DrumClock/AutoRotace/IMG_arduino.jpg

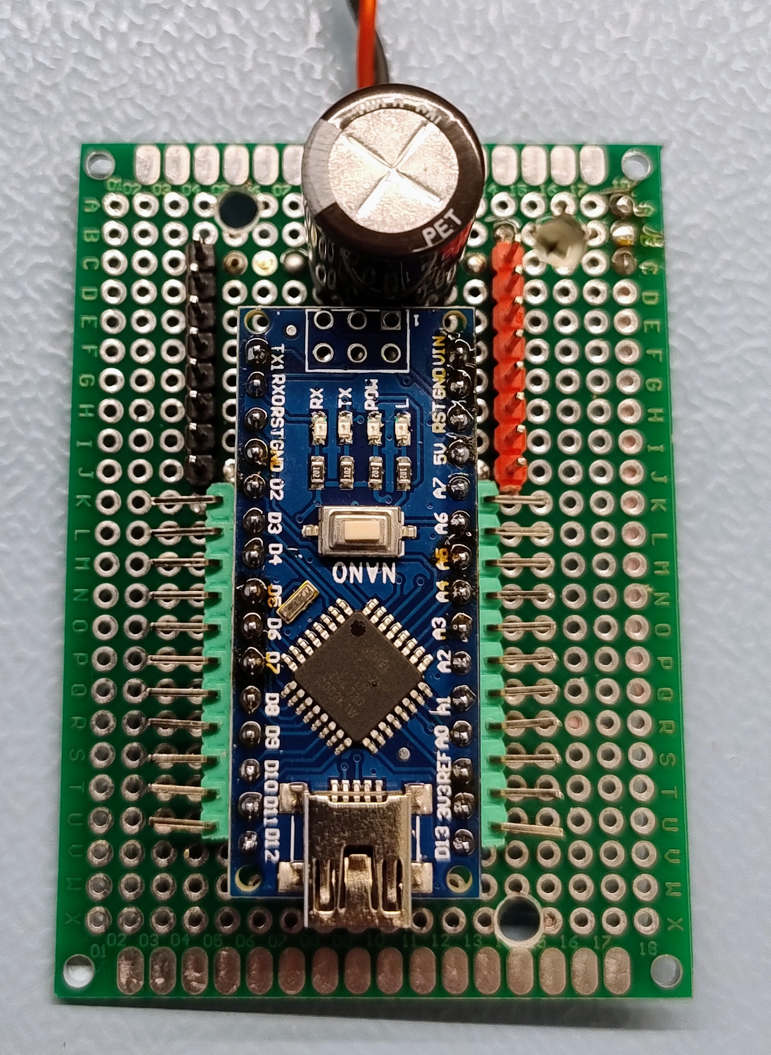
IMG_arduino.jpg
