DrumClock/AutoRotace/FreeCAD/SEVER_BEDNA_VRSEK_320mm.FCStd

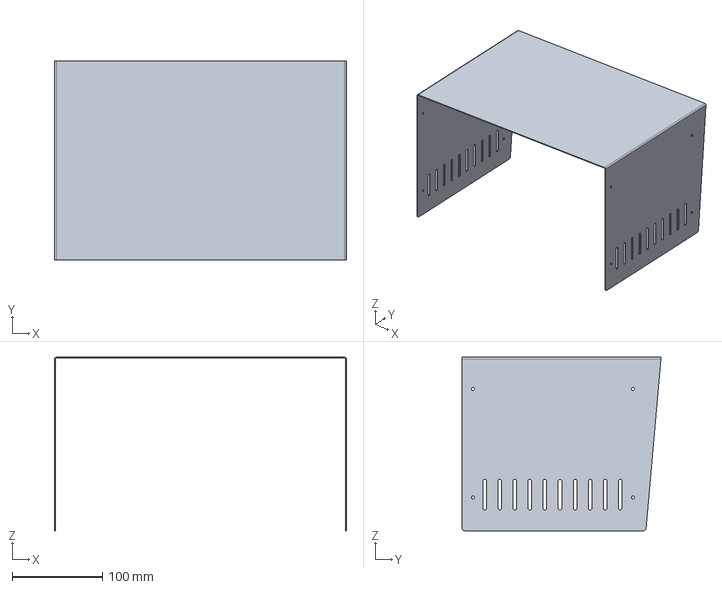
[picture p9: CAD file, 2025-06-11]
FreeCAD/SEVER_BEDNA_VRSEK_320mm.FCStd
323.0 x 220.0 x 192.0 mm
