DrumClock/AutoRotace/FreeCAD/bedna_nozicka.FCStd

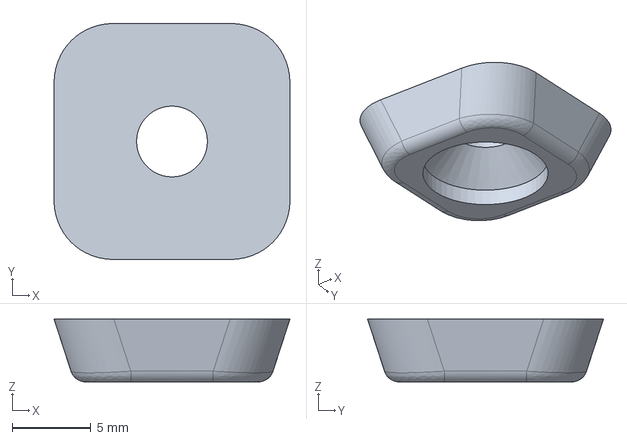
[picture p10: CAD file, 2025-06-11]
FreeCAD/bedna_nozicka.FCStd
15.0 x 15.0 x 4.00 mm
