DrumClock/AutoRotace/FreeCAD/SEVER_BEDNA_ZP_320mm.FCStd

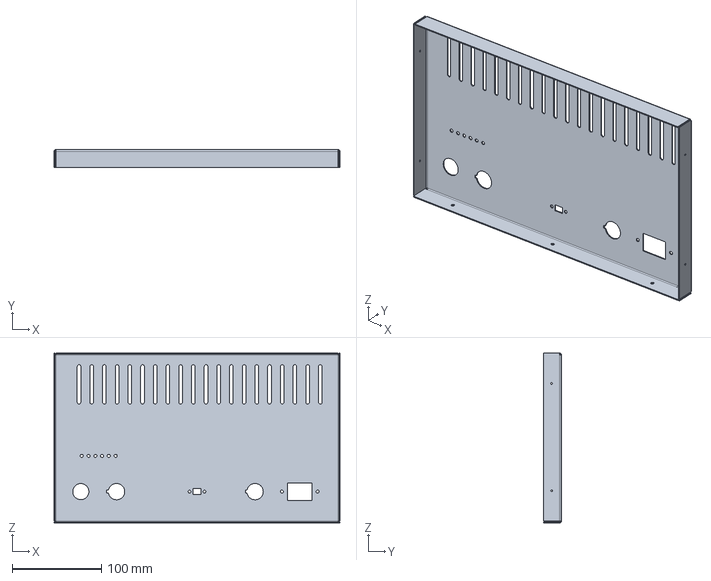
[picture p11: CAD file, 2025-06-11]
FreeCAD/SEVER_BEDNA_ZP_320mm.FCStd
320.0 x 20.0 x 190.0 mm
