DrumClock/AutoRotace/FreeCAD/SEVER_LOC.FCStd

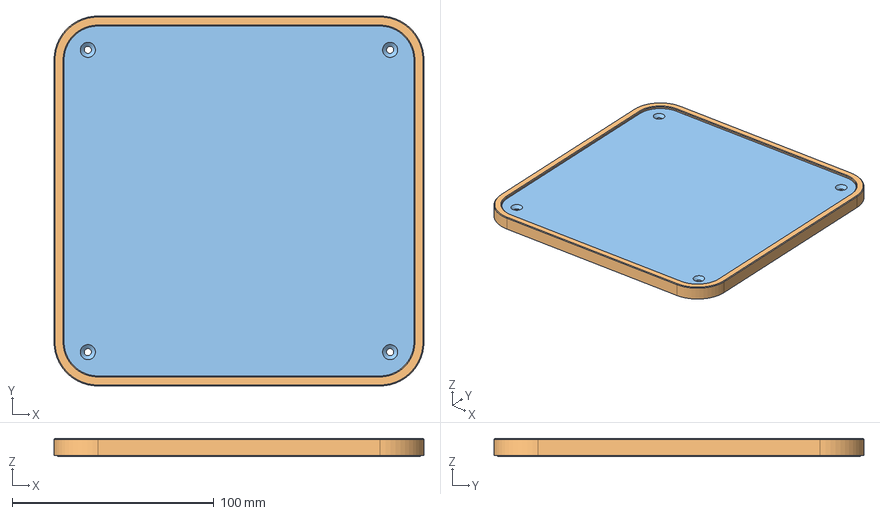
[picture p12: CAD file, 2025-06-11]
FreeCAD/SEVER_LOC.FCStd
183.6 x 183.6 x 9.10 mm
LED držák
rámeček
plexi 3mm
