DrumClock/AutoRotace/FreeCAD/rotace_tlacitka.FCStd

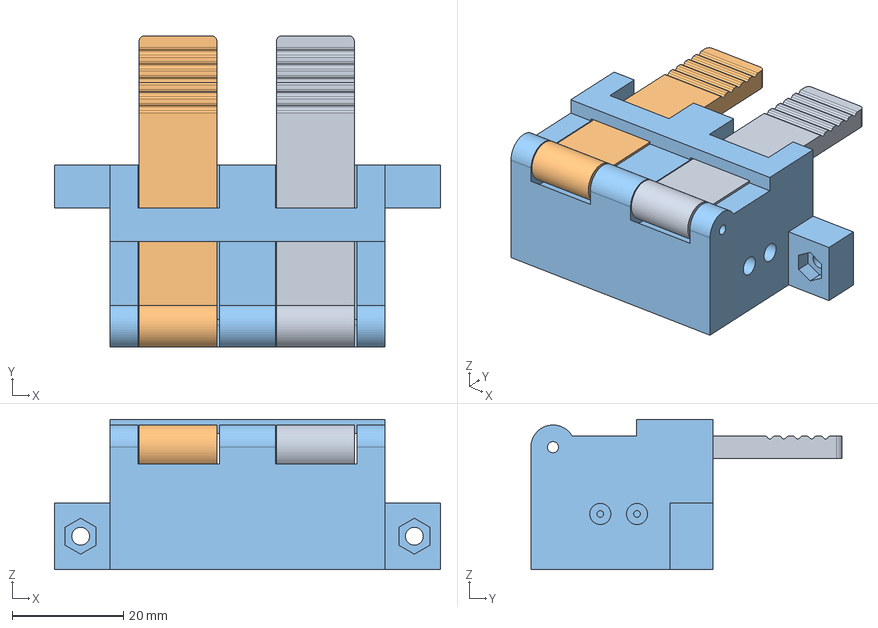
[picture p13: CAD file, 2025-06-11]
FreeCAD/rotace_tlacitka.FCStd
69.4 x 56.0 x 27.0 mm
páčka
packa2
drzak_spinacu
