DrumClock/AutoRotace/FreeCAD/SEVER_BEDNA_DNO_5mm.FCStd

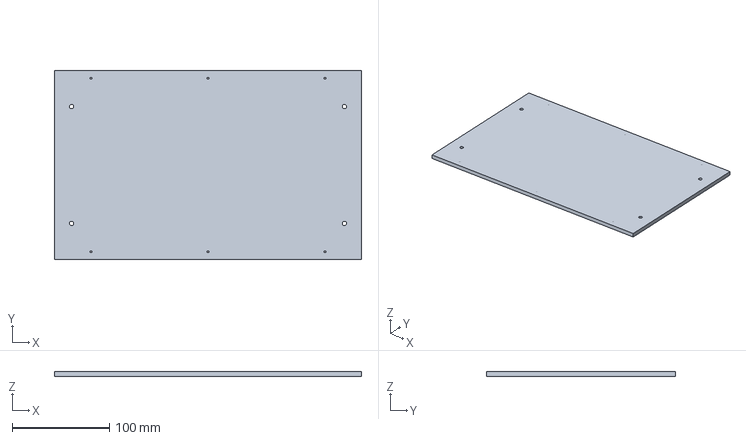
[picture p14: CAD file, 2025-06-11]
FreeCAD/SEVER_BEDNA_DNO_5mm.FCStd
315.0 x 194.0 x 5.00 mm
