DrumClock/AutoRotace/FreeCAD/SEVER_BEDNA_PP_320mm_DVE_PACKY.FCStd

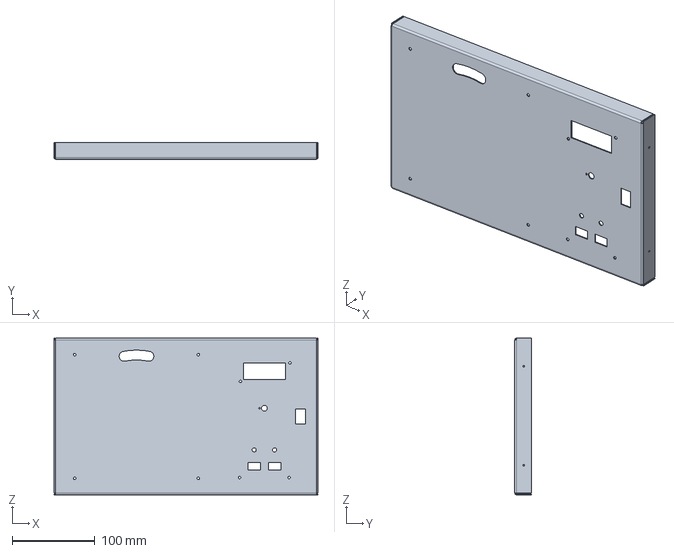
[picture p15: CAD file, 2025-06-11]
FreeCAD/SEVER_BEDNA_PP_320mm_DVE_PACKY.FCStd
320.0 x 20.0 x 190.0 mm
