DrumClock/AutoRotace/(list of files, cad)

Other CAD files:
FreeCAD/+++Sestava_BEDNY_4D_320mm_5mm.FCStd
