DrumClock/AutoRotace/IMG_zapojeni.jpg

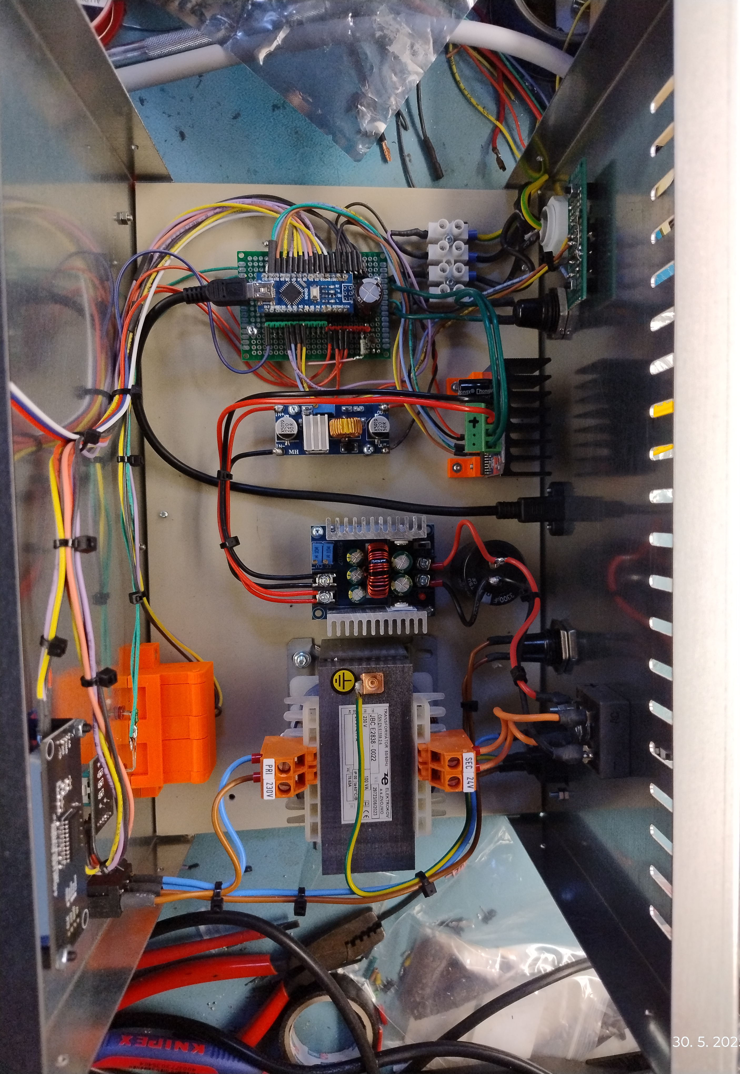
IMG_zapojeni.jpg
